janengelbrecht/LRMeter/LRMeterSchematics.bmp

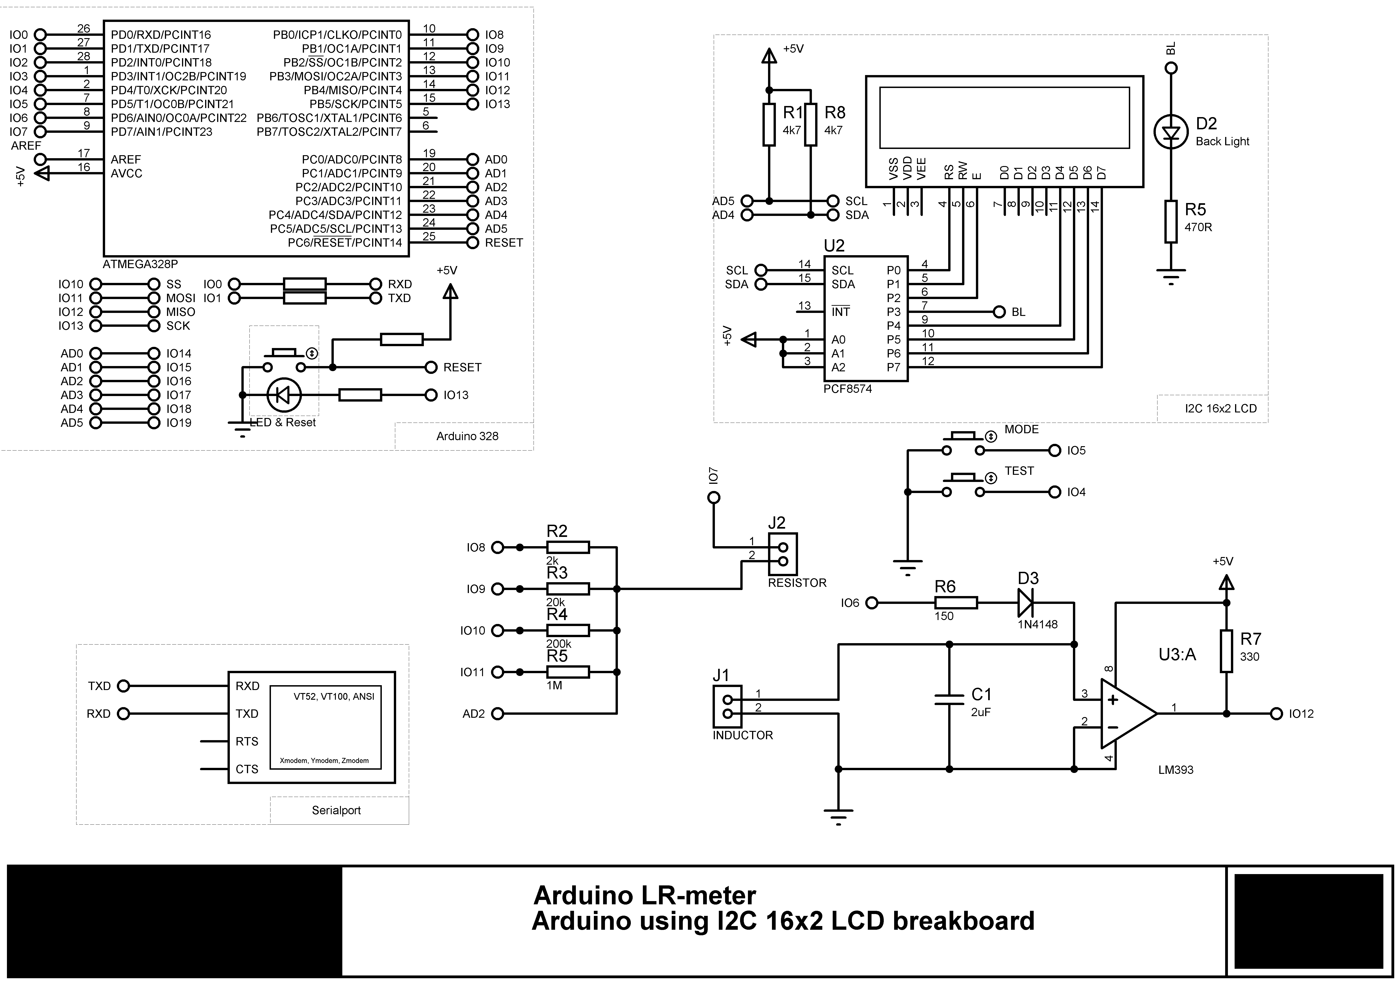
LRMeterSchematics.bmp
