janengelbrecht/LRMeter/LRMeterScematics.pdf

# Arduino using I2C 16x2 LCD breakboard D⁷ 14 D⁶ 13 D⁵ 12 D⁴ 11 D³ 10 D²

D2

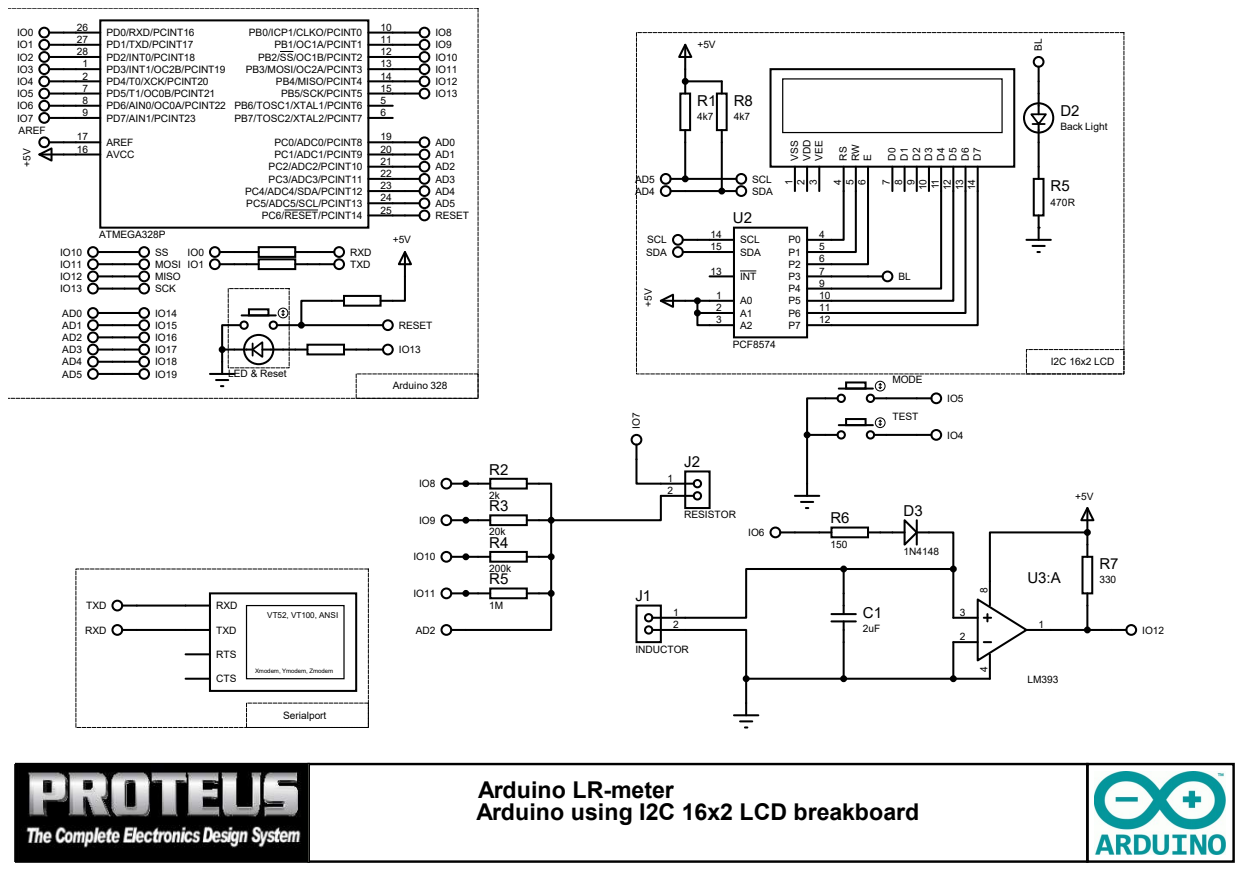
[picture p2: page 1]
